MaheshGit31/Laser-harp/README.md

# Laser-harp

An 8-string laser harp. Break a laser beam, and it plays a note. it shows up as a usb midi device, so it works with any daw or synth on your laptop.

## how it works
 
8 red lasers on the base shine straight up at 8 phototransistors on a bar on top of them. when your hand breaks a beam, that string's signal flips and the esp32 sends a midi note over usb. a neopixel under each string lights up while you play it.

## frame idea
 
a wood or 3d-printed arch holds the bar, hollow curved side pillars carry the cable, and a chunky base case holds the base pcb. none of this is built yet.

## images

kicad-base-screenshot
pcb-bar
pcb-base
