MaheshGit31/Laser-harp/images/block-diagram.png

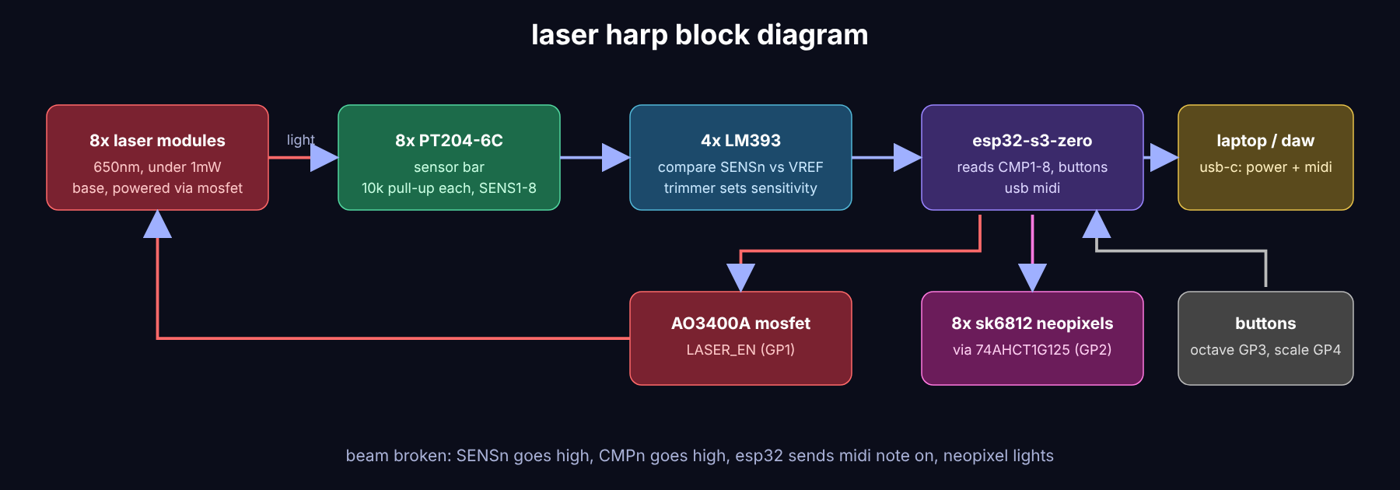
images/block-diagram.png
