MaheshGit31/Laser-harp/images/case-render.png

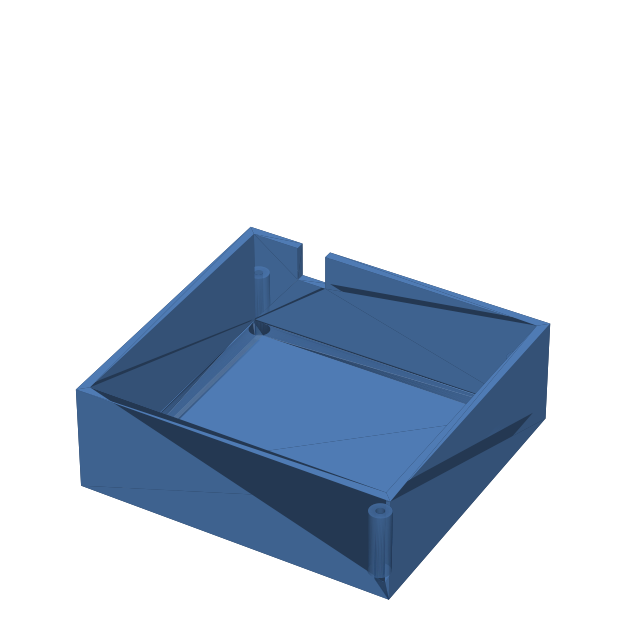
images/case-render.png
