MaheshGit31/Laser-harp/images/frame-design.png

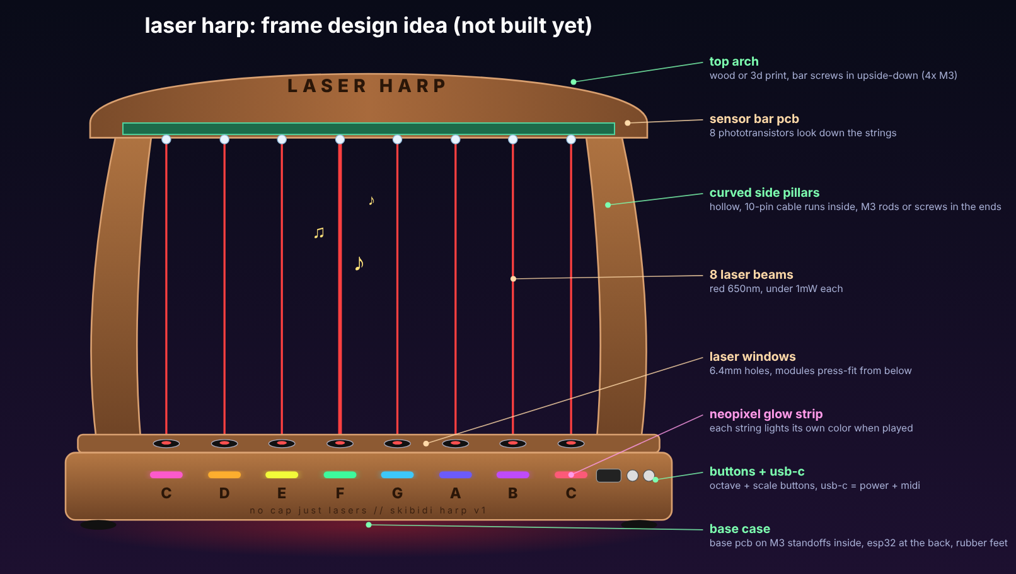
images/frame-design.png
