MaheshGit31/Laser-harp/images/kicad-base-screenshot.png

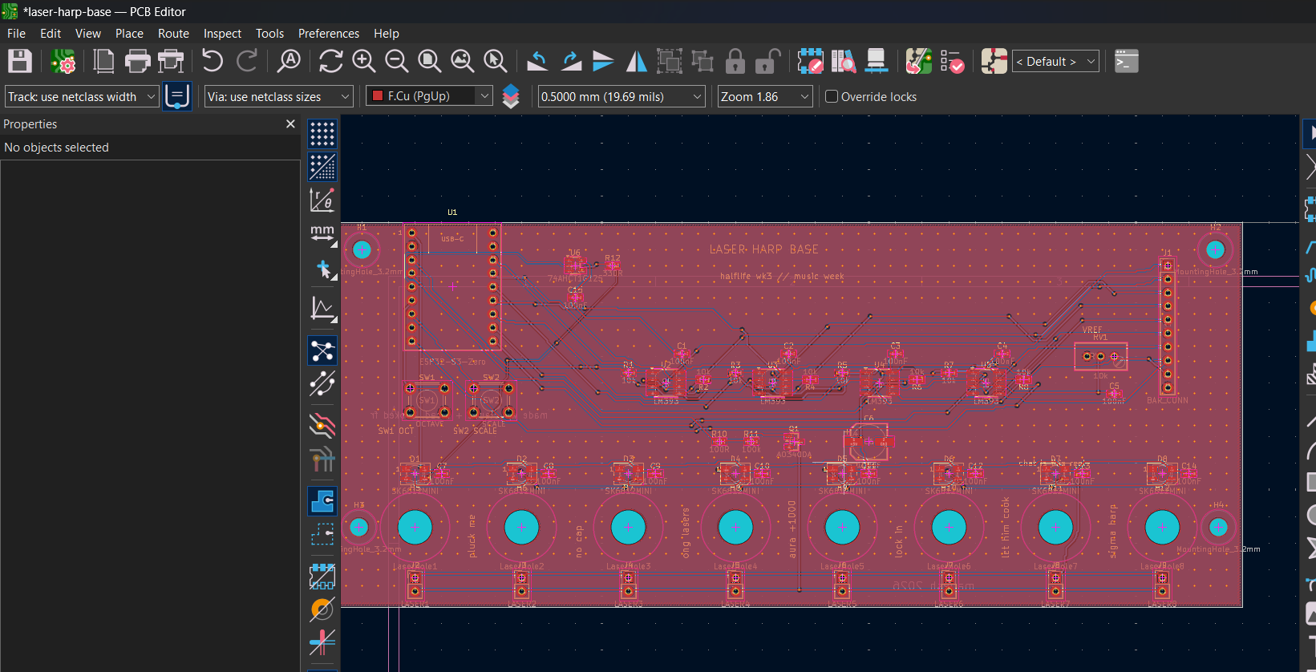
images/kicad-base-screenshot.png
