MaheshGit31/Laser-harp/images/pcb-bar.png

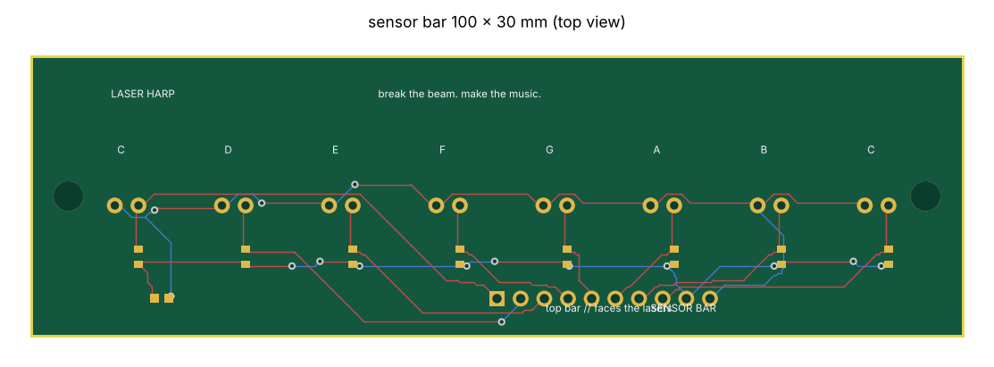
images/pcb-bar.png
