MaheshGit31/Laser-harp/images/pcb-base.png

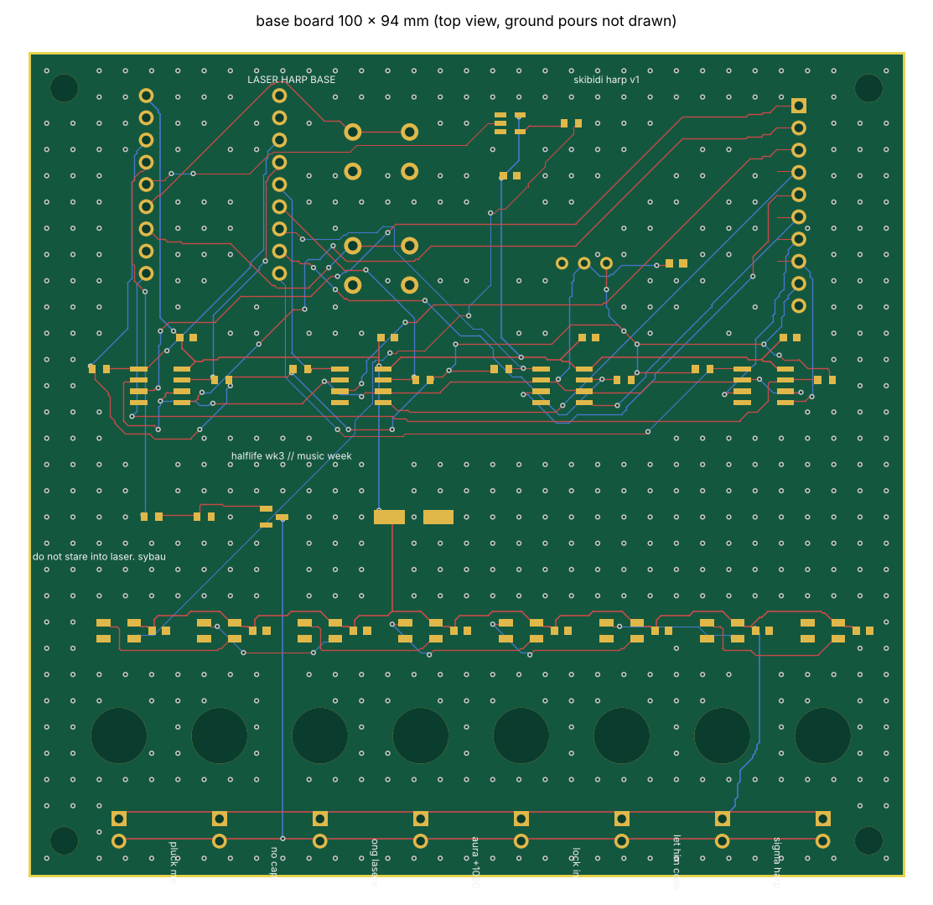
images/pcb-base.png
