MaheshGit31/Laser-harp/BOM.csv

part | qty | unit price (usd) | vendor | purpose | link | notes
ESP32-S3-Zero (U1) | 1 | 5.49 | Waveshare | brain of the harp, reads the 8 sensors and sends usb midi | https://www.waveshare.com/product/esp32-s3-zero.htm | price depends on variant and header (5.49 to 7.99)
LM393DR comparator (U2-U5) | 4 | 0.0326 | LCSC | turns each phototransistor signal into a clean on/off for the esp32 | https://www.lcsc.com/product-detail/C67470.html | from-price, moq not shown
74AHCT1G125 level shifter (U6) | 5 | 0.1374 | LCSC | 3.3V to 5V level shift for the neopixel data line | https://www.lcsc.com/product-detail/C151417.html | moq 5
AO3400A n-mosfet (Q1) | 5 | 0.0518 | LCSC | switches power to all 8 lasers from the esp32 | https://www.lcsc.com/product-detail/C20917.html | from-price, assumed moq 5
SK6812MINI-E LED (D1-D8) | 66 | 0.1742 | splitkb | one light under each string, lights up while you play it |  | only sold as a 66 pack, EUR 9.88 ex tax is about usd 11.50
PT204-6C phototransistor (bar Q1-Q8) | 10 | 0.068 | LCSC | senses each laser beam, clear lens | https://www.lcsc.com/product-detail/C98114.html | moq 10, clear lens (not 6B)
10k resistor 0603 (R1-R8 base and bar) | 20 | 0.0025 | LCSC | pull-ups and bias for the comparators and phototransistors | https://www.lcsc.com/product-detail/C25804.html | estimate, listed part was out of stock
100R / 100k / 330R resistors 0603 (R10-R12) | 3 | 0.01 | LCSC | gate pull-down, laser boot-off and led data resistor |  | estimated, not looked up
100nF capacitor 0603 (C1-C5, C7-C15, bar C1) | 100 | 0.0028 | LCSC | decoupling for chips, leds and the bar | https://www.lcsc.com/product-detail/C1591.html | moq 100
100uF 6.3V electrolytic 6.3x5.4mm (C6) | 5 | 0.092 | LCSC | bulk capacitor for lasers and leds | https://www.lcsc.com/product-detail/C336303.html | moq 5, showed out of stock when checked
10k trimmer 3296W (RV1) | 1 | 1.5 | Digi-Key (Bourns) | sets the comparator threshold for all 8 sensors |  | estimated, bourns 3296W-1-103, price not found
6x6mm tactile switch (SW1, SW2) | 10 | 0.046 | LCSC | octave and scale buttons | https://www.lcsc.com/product-detail/C2845265.html | moq 10, check it matches the footprint pitch
2.54mm pin headers (J1 x2 1x10, J2-J9 1x02) | 1 | 1.0 | any | board to board link and laser module power |  | estimated, break-away strips
650nm red laser module 1mW class 2 6x10.5mm | 8 | 2.03 | AliExpress (MZLASER Store) | the 8 laser strings | https://www.aliexpress.us/item/3256810422634398.html | 1mW variant, 3V. plus 9.79 shipping for 8, delivery nov 2-9. output not verified, check with a power meter
10-pin cable (dupont or ribbon) | 1 | 1.0 | any | connects the base board to the sensor bar |  | estimated
M3 rod or standoffs + nuts + washers | 1 | 3.0 | any hardware store | holds the case and frame together |  | estimated
usb-c cable | 1 | 0 | already owned | power and usb midi to the laptop |  | assumed owned
