MaheshGit31/Laser-harp/laser-harp-base-case.step

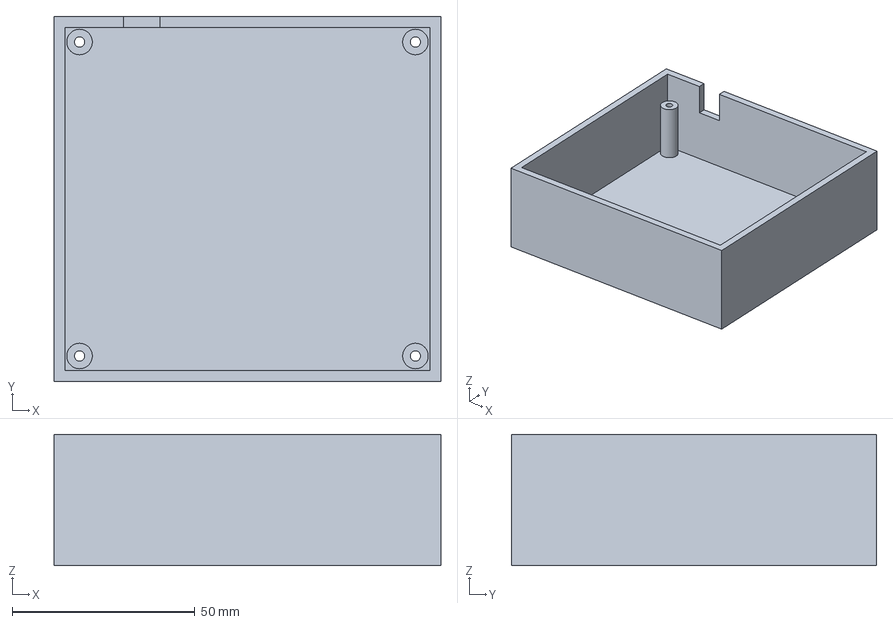
[picture p7: CAD file, 2026-10-26]
laser-harp-base-case.step
106.0 x 100.0 x 36.0 mm
