MaheshGit31/Laser-harp/laser-harp-bar.kicad_pcb

## KiCad design laser-harp-bar.kicad_pcb (2026-10-26)

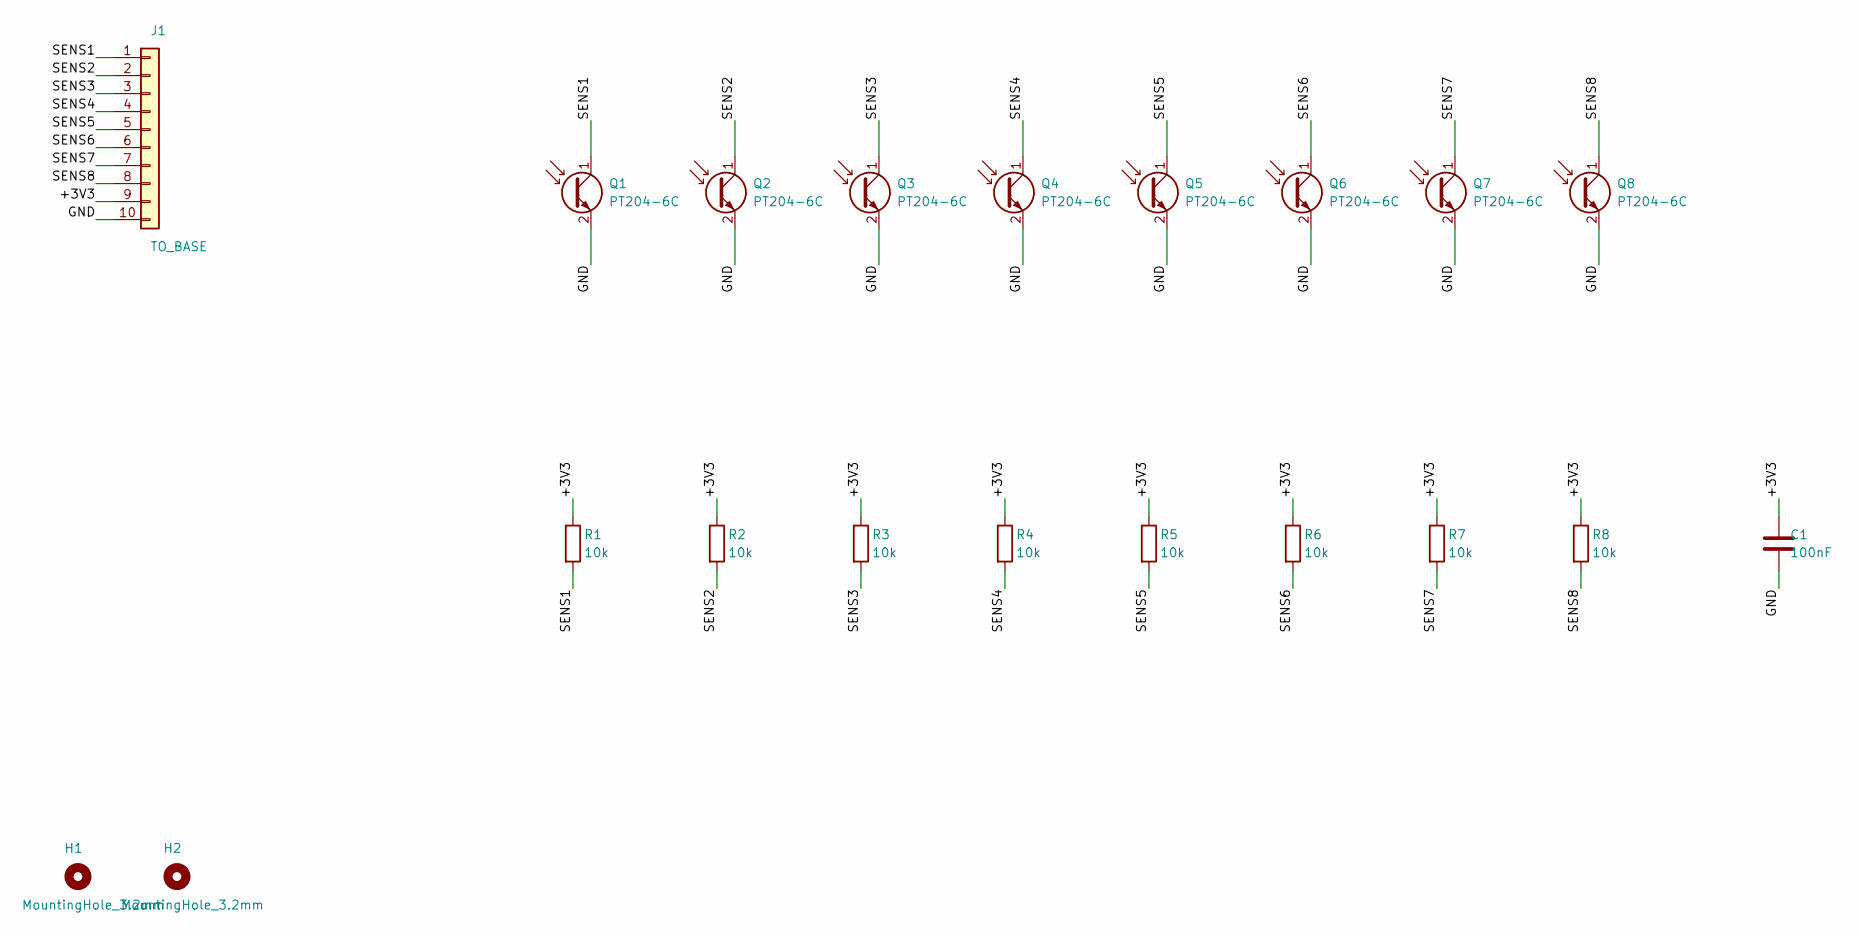
[picture p8: schematic laser-harp-bar.kicad_sch, Laser Harp - sensor bar (8 phototransistors)]

Parts:
C1: 100nF; C_0603_1608Metric
H1, H2: MountingHole_3.2mm; MountingHole_3.2mm_M3
J1: TO_BASE; PinHeader_1x10_P2.54mm_Vertical
Q1, Q2, Q3, Q4, Q5, Q6, Q7, Q8: PT204-6C; PT204-6C_D3.0mm
R1, R2, R3, R4, R5, R6, R7, R8: 10k; R_0603_1608Metric

Connections:
/+3V3: C1.1, J1.9, R1.1, R2.1, R3.1, R4.1, R5.1, R6.1, R7.1, R8.1
/GND: C1.2, J1.10, Q1.2 (E), Q2.2 (E), Q3.2 (E), Q4.2 (E), Q5.2 (E), Q6.2 (E), Q7.2 (E), Q8.2 (E)
/SENS1: J1.1, Q1.1 (C), R1.2
/SENS2: J1.2, Q2.1 (C), R2.2
/SENS3: J1.3, Q3.1 (C), R3.2
/SENS4: J1.4, Q4.1 (C), R4.2
/SENS5: J1.5, Q5.1 (C), R5.2
/SENS6: J1.6, Q6.1 (C), R6.2
/SENS7: J1.7, Q7.1 (C), R7.2
/SENS8: J1.8, Q8.1 (C), R8.2

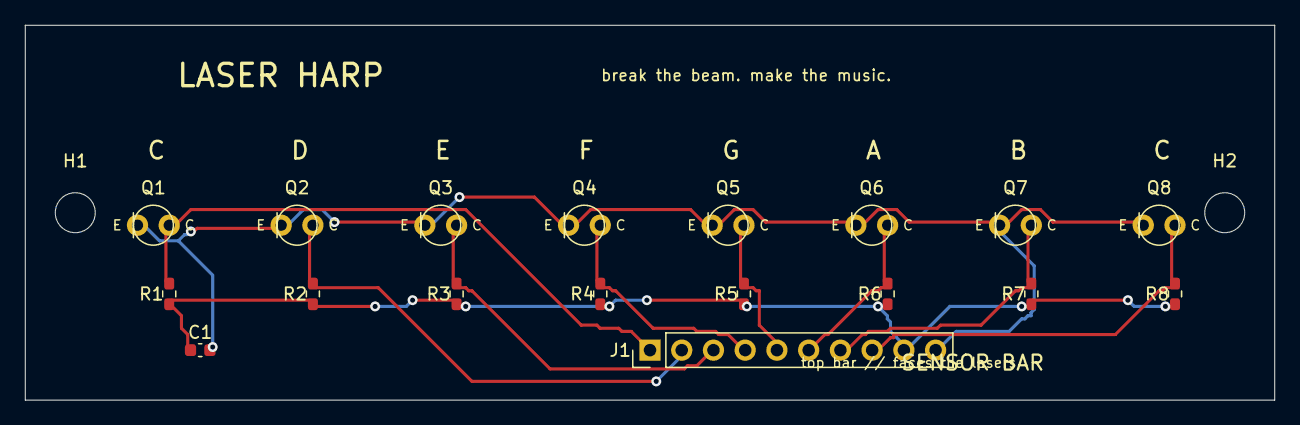
[picture p9: board laser-harp-bar.kicad_pcb from above]

Board: 2 copper layers, 100.0 x 30.0 mm, 20 parts (0 on the bottom side), 10 nets.
