MaheshGit31/Laser-harp/laser-harp-base.kicad_pcb

## KiCad design laser-harp-base.kicad_pcb (2026-10-26)

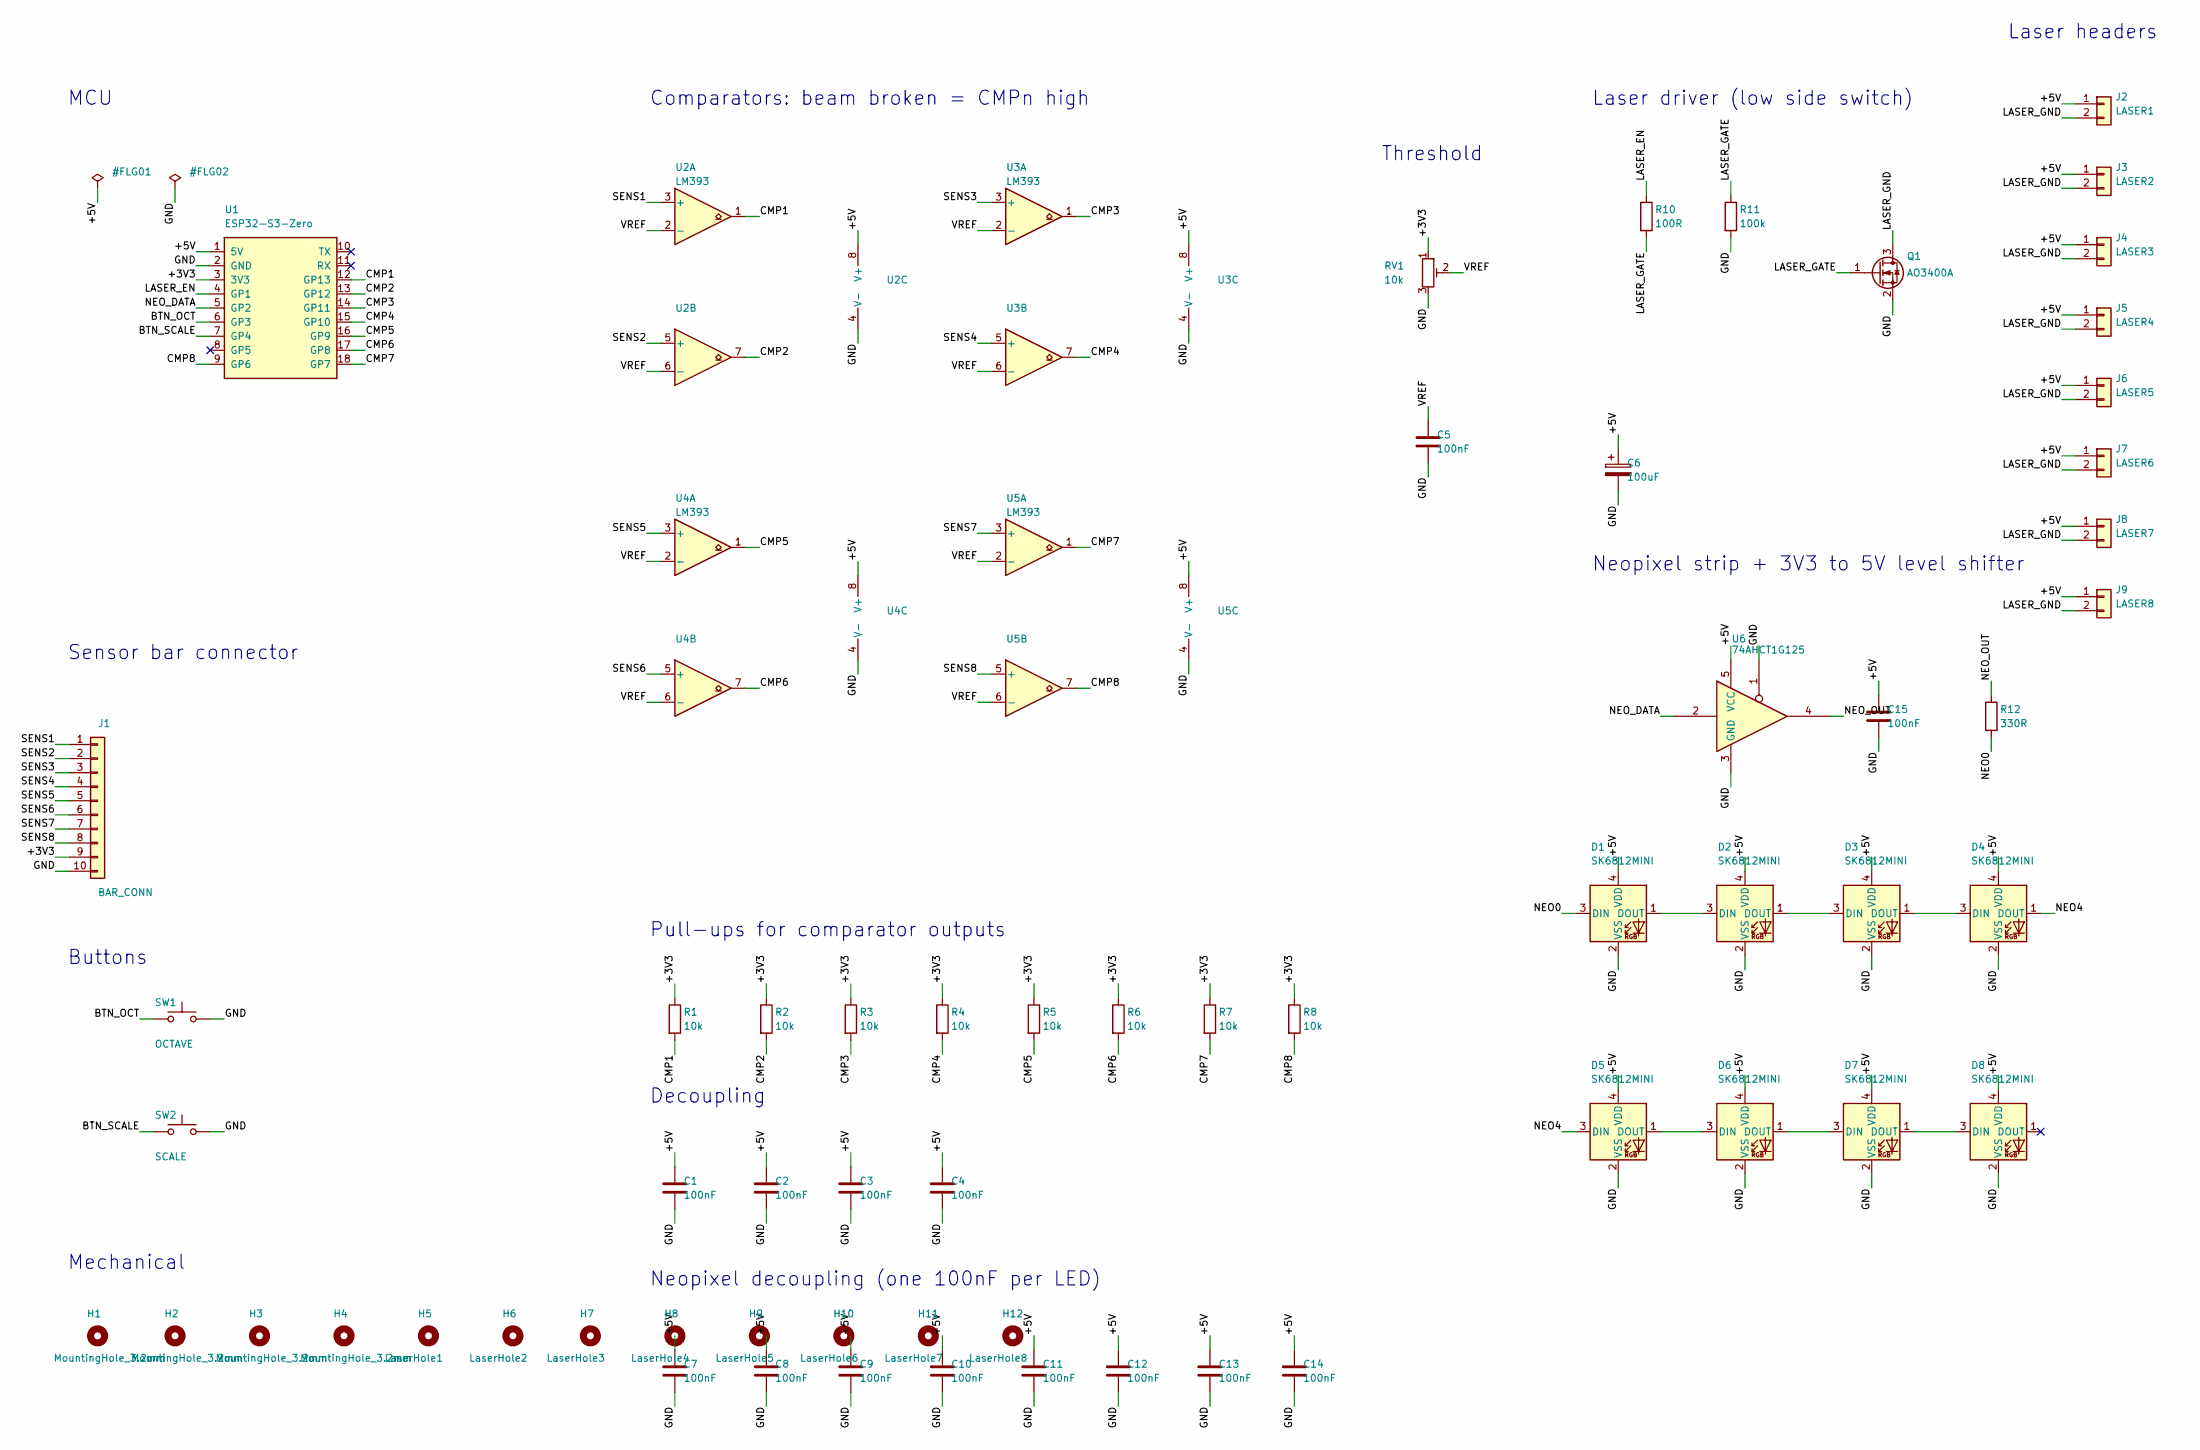
[picture p10: schematic laser-harp-base.kicad_sch, Laser Harp - base board (MCU, comparators, laser driver, ne…]

Parts:
C1, C2, C3, C4, C5, C7, C8, C9, C10, C11, C12, C13, C14, C15: 100nF; C_0603_1608Metric
C6: 100uF; CP_Elec_6.3x5.4
D1, D2, D3, D4, D5, D6, D7, D8: SK6812MINI; LED_SK6812MINI_PLCC4_3.5x3.5mm_P1.75mm
H1, H2, H3, H4: MountingHole_3.2mm; MountingHole_3.2mm_M3
H5: LaserHole1; MountingHole_6.4mm_M6
H6: LaserHole2; MountingHole_6.4mm_M6
H7: LaserHole3; MountingHole_6.4mm_M6
H8: LaserHole4; MountingHole_6.4mm_M6
H9: LaserHole5; MountingHole_6.4mm_M6
H10: LaserHole6; MountingHole_6.4mm_M6
H11: LaserHole7; MountingHole_6.4mm_M6
H12: LaserHole8; MountingHole_6.4mm_M6
J1: BAR_CONN; PinHeader_1x10_P2.54mm_Vertical
J2: LASER1; PinHeader_1x02_P2.54mm_Vertical
J3: LASER2; PinHeader_1x02_P2.54mm_Vertical
J4: LASER3; PinHeader_1x02_P2.54mm_Vertical
J5: LASER4; PinHeader_1x02_P2.54mm_Vertical
J6: LASER5; PinHeader_1x02_P2.54mm_Vertical
J7: LASER6; PinHeader_1x02_P2.54mm_Vertical
J8: LASER7; PinHeader_1x02_P2.54mm_Vertical
J9: LASER8; PinHeader_1x02_P2.54mm_Vertical
Q1: AO3400A; SOT-23
R1, R2, R3, R4, R5, R6, R7, R8: 10k; R_0603_1608Metric
R10: 100R; R_0603_1608Metric
R11: 100k; R_0603_1608Metric
R12: 330R; R_0603_1608Metric
RV1: 10k; Potentiometer_Bourns_3296W_Vertical
SW1: OCTAVE; SW_PUSH_6mm
SW2: SCALE; SW_PUSH_6mm
U1: ESP32-S3-Zero
U2, U3, U4, U5: LM393; SOIC-8_3.9x4.9mm_P1.27mm
U6: 74AHCT1G125; SOT-23-5

Connections:
/+3V3: J1.9, R1.1, R2.1, R3.1, R4.1, R5.1, R6.1, R7.1, R8.1, RV1.1, U1.3 (3V3)
/+5V: C1.1, C2.1, C3.1, C4.1, C6.1, C7.1, C8.1, C9.1, C10.1, C11.1, C12.1, C13.1, C14.1, C15.1, D1.4 (VDD), D2.4 (VDD), D3.4 (VDD), D4.4 (VDD), D5.4 (VDD), D6.4 (VDD), D7.4 (VDD), D8.4 (VDD), J2.1, J3.1, J4.1, J5.1, J6.1, J7.1, J8.1, J9.1, U1.1 (5V), U2.8 (V+), U3.8 (V+), U4.8 (V+), U5.8 (V+), U6.5 (VCC)
/BTN_OCT: SW1.1, U1.6 (GP3)
/BTN_SCALE: SW2.1, U1.7 (GP4)
/CMP1: R1.2, U1.12 (GP13), U2.1
/CMP2: R2.2, U1.13 (GP12), U2.7
/CMP3: R3.2, U1.14 (GP11), U3.1
/CMP4: R4.2, U1.15 (GP10), U3.7
/CMP5: R5.2, U1.16 (GP9), U4.1
/CMP6: R6.2, U1.17 (GP8), U4.7
/CMP7: R7.2, U1.18 (GP7), U5.1
/CMP8: R8.2, U1.9 (GP6), U5.7
/GND: C1.2, C2.2, C3.2, C4.2, C5.2, C6.2, C7.2, C8.2, C9.2, C10.2, C11.2, C12.2, C13.2, C14.2, C15.2, D1.2 (VSS), D2.2 (VSS), D3.2 (VSS), D4.2 (VSS), D5.2 (VSS), D6.2 (VSS), D7.2 (VSS), D8.2 (VSS), J1.10, Q1.2 (S), R11.2, RV1.3, SW1.2, SW2.2, U1.2 (GND), U2.4 (V-), U3.4 (V-), U4.4 (V-), U5.4 (V-), U6.1, U6.3 (GND)
/LASER_EN: R10.1, U1.4 (GP1)
/LASER_GATE: Q1.1 (G), R10.2, R11.1
/LASER_GND: J2.2, J3.2, J4.2, J5.2, J6.2, J7.2, J8.2, J9.2, Q1.3 (D)
/NEO0: D1.3 (DIN), R12.2
/NEO4: D4.1 (DOUT), D5.3 (DIN)
/NEO_DATA: U1.5 (GP2), U6.2
/NEO_OUT: R12.1, U6.4
/SENS1: J1.1, U2.3 (+)
/SENS2: J1.2, U2.5 (+)
/SENS3: J1.3, U3.3 (+)
/SENS4: J1.4, U3.5 (+)
/SENS5: J1.5, U4.3 (+)
/SENS6: J1.6, U4.5 (+)
/SENS7: J1.7, U5.3 (+)
/SENS8: J1.8, U5.5 (+)
/VREF: C5.1, RV1.2, U2.2 (-), U2.6 (-), U3.2 (-), U3.6 (-), U4.2 (-), U4.6 (-), U5.2 (-), U5.6 (-)
unnamed: D1.1 (DOUT), D2.3 (DIN)
unnamed: D2.1 (DOUT), D3.3 (DIN)
unnamed: D3.1 (DOUT), D4.3 (DIN)
unnamed: D5.1 (DOUT), D6.3 (DIN)
unnamed: D6.1 (DOUT), D7.3 (DIN)
unnamed: D7.1 (DOUT), D8.3 (DIN)

Notes on the sheet:
MCU
Sensor bar connector
Buttons
Comparators: beam broken = CMPn high
Threshold
Laser driver (low side switch)
Laser headers
Neopixel strip + 3V3 to 5V level shifter
Pull-ups for comparator outputs
Decoupling
Neopixel decoupling (one 100nF per LED)
Mechanical

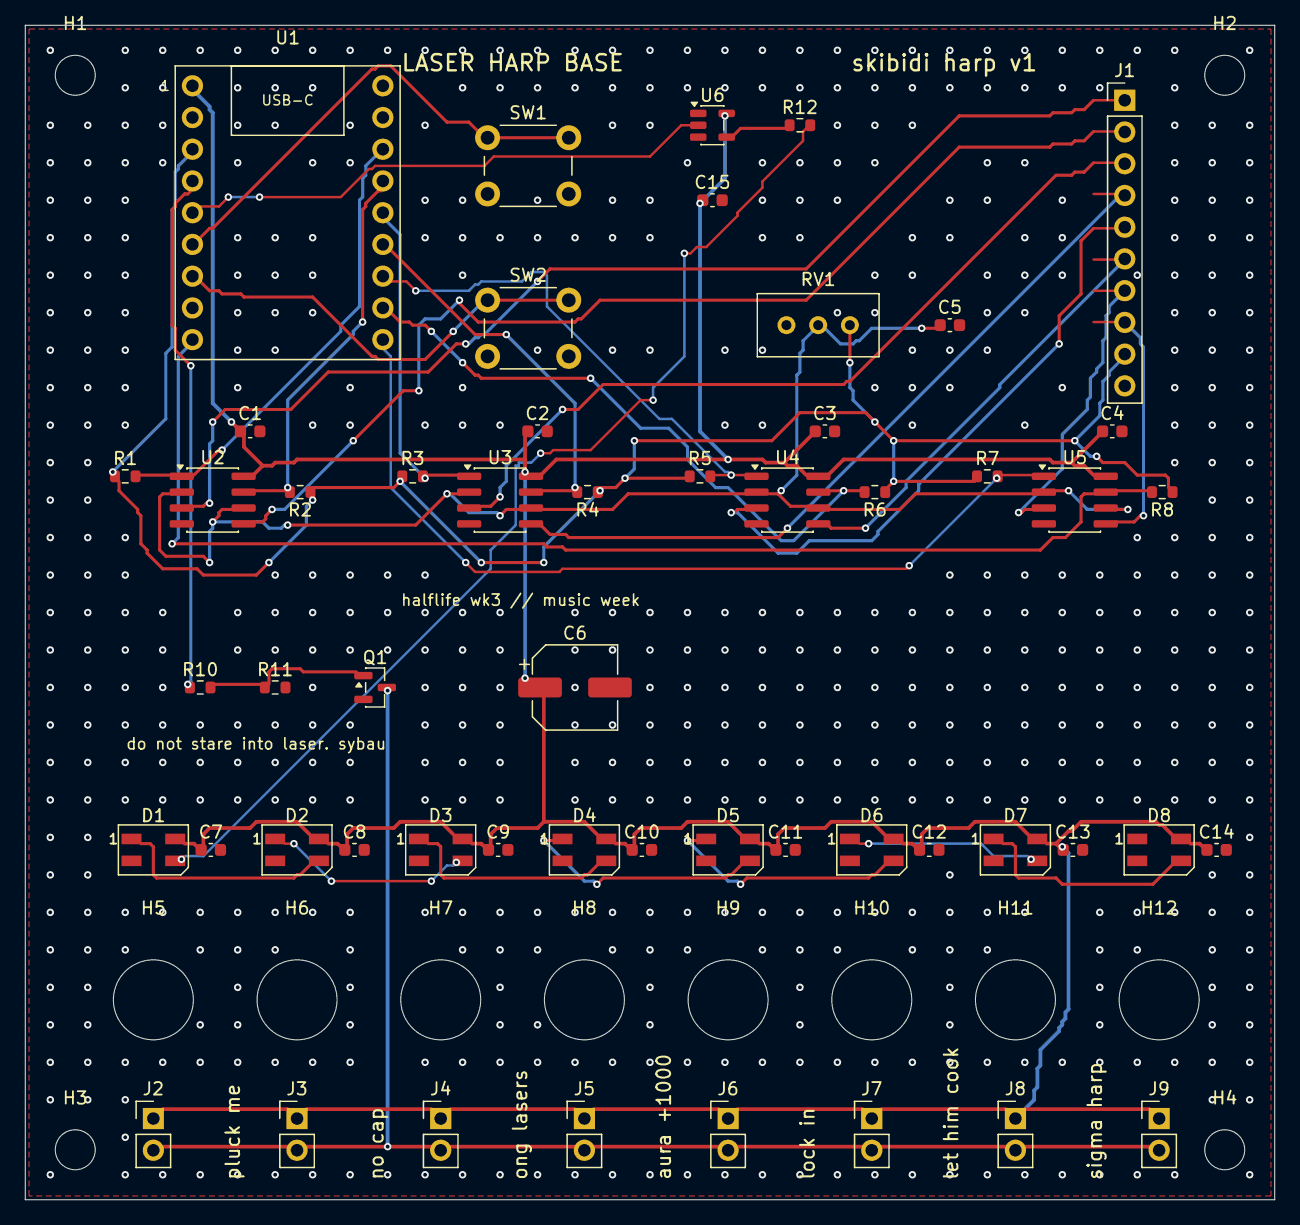
[picture p11: board laser-harp-base.kicad_pcb from above]

Board: 2 copper layers, 100.0 x 94.0 mm, 65 parts (0 on the bottom side), 35 nets.
