MaheshGit31/Laser-harp/(commit log)

2026-10-22 Make readme better :D
    Expanded the description of the laser harp, detailing its functionality and frame design.
2026-10-23 added submission stuff
    [BOM.csv, laser-harp-bar.kicad_pcb, laser-harp-bar.kicad_sch, laser-harp-base.kicad_pcb, laser-harp-base.kicad_sch]
2026-10-23 Update BOM.csv with new part details
    [BOM.csv]
2026-10-23 Update BOM.csv with new item entries
    [BOM.csv]
2026-10-26 added finishing touches
    [BOM.csv, laser-harp-bar.kicad_pcb, laser-harp-base-case.step, laser-harp-base.kicad_pcb]
2026-10-26 made bom right format
    [BOM.csv]
